Jinchen-Yang/race-car/README.md

# race-car — 2026 电赛自动行驶小车(TI MSPM0G3507)

北邮 2026 电赛小车赛道题固件:220×120cm 场地、双 R=40cm 半圆弧黑线 + 空白直线段,
要求自动巡迹一圈(F1 ≤30s)、定点瞄准(F2 ≤5s)、巡迹+对靶联动(F3 ≤40s)、四圈连跑(发挥)。

**当前状态**:循迹全线已通(单圈 ≈20s,真机验收)·r37 AIM 云台恢复 + Serial Studio CSV 灰度抗阴影/I2C 排障版。

---

## 1. 硬件

| 部件 | 型号/说明 | 接口 |
|---|---|---|
| 主控 | LP-MSPM0G3507 LaunchPad | — |
| 电机驱动 | 成品四路板(2×TB6612FNG),Motor A=左 B=右 | PWM: TIMA0 PA8/PB9;方向 PA12/PA13/PB6/PB7;STBY PB0 |
| 编码器 | MG310 自带 AB 相(左 QEI 4倍频 / 右 GPIO 1倍频) | 左 TIMG8 PA29/PA30;右 PA27/PB24。**r20 起仅作遥测,不参与控制** |
| 灰度 | 感为 8 路 IIC 版(Rev V3.6),地址 0x4C | I2C1 PB2/PB3 |
| IMU | MPU6050(GY-521),yaw 左转为正 | I2C0 PA0/PA1 |
| 云台 | 水平 360°连续舵机实际接 TILT/PA16; 垂直 180°位置舵机实际接 PAN/PA17 | 舵机轨开关 PB23(限制⑥) |
| 激光 | 装于 PAN 云台,与镜头位同轴向;供电走舵机轨 | — |
| 视觉(选配) | K230(CanMV),跑 `k230_aim_main.py` | UART2:PB17→K230 RXD,PB16←TXD |
| 人机 | START=PB19 MODE=PA22 蜂鸣=PB18 RUN灯=PA24 ERR灯=PA26 | 调试串口 UART0(XDS110) |

供电:电机/驱动板走电池 Vin;主控+灰度暂走 USB/充电宝(5V buck 割接待做);舵机轨接驱动板 5V。

## 2. 固件架构(r25 起,CTY 式)

```
scheduler(1ms 时基) ── 任务表轮询
├─ track_loop_step(20ms)  转向核: 一切误差统一折算成 DeltaYaw(°) → PD → 左右差速占空
│    ├─ 弧线段: 灰度 8 位查表(±5/15/25/40°) + 丢线强拐搜索
│    ├─ 空白段: 绝对航向保持(段0 目标=z, 段2 目标=z+180; z=START 时车头方向)
│    └─ 四段状态机: 压线/离线事件驱动(漏积分计数认线), 一圈 4 节点 B/C/D/A
├─ vel_loop_step(10ms)    r20 起仅编码器测速遥测(速度闭环已弃用)
├─ app_fsm_step(10ms)     IDLE/RUN/AIM/STOP/ESTOP; 节点声光/模式路由/四圈计圈
└─ task_vofa / task_cmd   24 通道遥测 + 串口命令台
```

模式(IDLE 下 MODE 键循环或串口发 1~4,RUN 灯每 2s 闪"模式号"次):
**1**=F1 巡迹一圈停 A · **2**=F2 定点瞄准 · **3**=F3 到 B 停车对靶后续跑 · **4**=四圈连跑(每圈过 A 限幅重锚 ±10° 清陀螺漂移)。
START 起跑;运动中任意键=急停;ESTOP 下 2s 内三连按 START 软清障。

## 3. 定版参数(真机整定,2026-07-06)

| 参数 | 值 | 含义 |
|---|---|---|
| TRACK_KP / TRACK_KD | **6.0 / 2.0** | SelfTurn PD(占空差/°);TRACK_KP 只用于直线航向保持 |
| TRACK_KP_ARC | **3.5** | r32 增益分家:弧线质心专用 KP(`P/p` 调的是它);曾用 6.0,弧上激出 S 型极限环 |
| BASE_SPEED | **170** | 巡航占空(r25 起是占空不是 mm/s)。⚠r39 起弧线曲率前馈 ∝ base,改基速会同步改变前馈量 |
| DRIVE_TRIM_DUTY_R | **5** | 右轮占空配平(`T/t` 调) |
| ARC_FF_EN / ARC_RADIUS_MM / WHEEL_TRACK_MM | **1 / 400.0 / 140.0** | r39 弧线曲率前馈:`ff = base·track/(2R)`。⚠轮距 140 为**估值**,实测后回填 |
| GRAY_LOOKAHEAD_MM | **110.0** | r40 传感器前置量:灰度阵列中心→驱动轮轴的纵向距离。决定出弧时前馈再托几帧。⚠**估值**,尺子量了回填。判据:CSV 里 `seg` 从 1 跳到 2 那一拍的 `dy` 应≈0(强负=欠转,强正=过转) |
| SEG_LINE_TH / SEG_BLANK_TH | 8 / 16 | 认线≈5帧 / 认空白≈16帧(勿轻动:调松到 63 曾致误触发链) |
| START_PROTECT_MS | 1500 | 起步 1.5s 无视灰度(摆车须离胶带 ≥50cm) |
| 每圈重锚限幅 | ±10° | 模式 4 专用;r39 起是纯陀螺漂移的**唯一**长期基准(模式 1/3 单圈内无任何修正) |

> r39 弧线整定判据(与基速无关):弧上稳态时 CSV 的 `gray_err` 应落回 0 附近(r38 及以前常驻 ≈+71,线骑阵列外缘)。仍偏正=`WHEEL_TRACK_MM` 估小了,偏负=估大了,按 `|gray_err|` 比例回填。

## 4. 构建/烧录/调试

- **环境**:CCS Theia + MSPM0 SDK 2.10.00.04 + SysConfig 1.26.2 + tiarmclang(工程内 .cproject 已配好,导入即编)
- **水印制度**:每次烧录后看 boot 串口横幅的 rN 版本号,与预期不符=烧了个寂寞
- **Serial Studio 临时灰度排障模式**:`empty.c` 里 `SERIAL_STUDIO_CSV=1` 时,串口每 50ms 输出纯数字 CSV: `ms,state,gray_err,lost,fresh,ok_delta,fail_delta,raw_or_neg1,gray_hits,line_ok,gray_min_hits,aim_stop_us,trim,arc_kp_x100,kd_x100,arc_scale_x1000,base,line_kp_x100,dy,seg,turn_diff,left_duty,right_duty,nodata,protect_ms,startprot_ms`。Serial Studio 选 XDS110 串口、115200、Quick Plot 即可;重点看 `fail_delta` 是否随晃线冒尖、`raw_or_neg1` 白地是否约 255；若 `fresh=0` 则 `raw_or_neg1=-1`,表示原始字节无效。`gray_hits` 是本帧黑点数,`line_ok=1` 才会被循迹当真线; `G/g` 调 `gray_min_hits` 抗阴影,`Y/y` 调水平连续舵机停转脉宽 `aim_stop_us`。CSV 模式下 `P/p D/d A/a V/v H/h T/t G/g Y/y O/o` 字符调参静默生效,参数列会跟着跳变;突然右转时看 `seg` 是否提前从 0 跳到 1、`turn_diff` 是否为负、左右占空是否拉开。
- **VOFA+**:`SERIAL_STUDIO_CSV=0` 时恢复 JustFloat 24 通道。要点通道:I0 状态机 · I10 灰度质心 · I11 丢线 · I15 灰度原始字节(白地=255) · I13/I14 灰度 I2C 成败计数 · I20 当前段目标航向 · I21 转向量 · I23 右轮配平
- **命令台**(VOFA 发送框):`1~4` 模式 · `s` 启动 · `x` 急停 · `r` STOP 回待机/ESTOP 三连确认 · `P/p` 弯道KP±0.5 · `D/d` KD±1 · `A/a` 灰度质心到角度比例±0.01 · `V/v` 基速占空±10 · ~~`H/h` 直线航向KP~~(**死旋钮**:`g_heading_kp` 属 r20 盲走架构,r25 段状态机上线后无人引用,调它只改回显不改行为;直线 KP 是定版 `TRACK_KP=6.0`,不在线调) · `T/t` 右轮配平±3 · `G/g` 灰度门槛±1 · `O/o` 舵机轨上/下电 · `C` 云台中位 · `J/j` PAN±1° · `K/k` TILT±5° · `Y/y` 连续舵机停转脉宽±5us · `?` 回显+帮助。
- ⚠ 串口在线调的参数**断电即失**,定版值必须写回 `app.c` 常量再烧

### 舵机/云台快调

当前安全初值在 `servo.c`:50Hz、0.6~2.4ms、PAN 10..170°、TILT 40..140°、中位 90°。r37 实测通道角色相反:水平 360° 连续舵机在 `SERVO_TILT/PA16`,垂直 180° 位置舵机在 `SERVO_PAN/PA17`。AIM 默认 `AIM_FIXED_MODE=1`: 前 305ms 给水平连续舵机手势脉宽,之后发 `aim_stop_us` 停转保持;垂直位置舵机斜坡到 `AIM_ELEV_DEG`。若水平舵机蠕转,在 IDLE/STOP 下先 `O` 上电,用 `Y/y` 微调到不转,再把回显值写回 `AIM_CONT_STOP_US`。

## 5. K230 视觉(选配,拔掉不影响 F1~F3)

`k230_aim_main.py` 跑在 K230(CanMV IDE 调阈值,部署=存板上 main.py):黑阈值找靶心 →
每帧发 `AA 55 06 05 dxL dxH dyL dyH found CHK 0D`(协议见 `protocol.h`,主控 `k230.c` 解析,
200ms 无帧自动回退纯几何瞄准)。接线:K230 4pin 口 TXD→PB16、RXD→PB17、共地;K230 开机需 ~10s。

## 6. 待办与已知问题

- [ ] 瞄准标定:场地常量已实测(AB=1000 / 靶投影 530 / 靶心高 500 / 舵机轴高 161.5 mm;解算角 +133° → **云台中位必须装成指左**),按 `servo_gimbal_bringup.md` 回填端点/零点/符号
- [ ] 已知偶发:高速垂直冲线偶尔认不出(≈3 帧 < 认线 5 帧);根治方案=触线降速确认,待实施
- [ ] 供电割接(5V buck 上车)、F1 录像、模式 4 四圈复测(r29)、F3 干跑
- 调试全史见 `git log`:每轮改动一条 commit,含现象→机理→修复的完整记录

## 7. 文件导览

`app.c/h` 控制核+状态机(主战场) · `empty.c` 调度/遥测/命令台 · `gray.c` 感为灰度 · `mpu6050.c` IMU ·
`motor.c` TB6612 · `encoder.c` 编码器 · `servo.c` 云台 · `k230.c` 视觉收帧 · `protocol.h` UART 契约 ·
`vofa.c` JustFloat · `pid.c` PID · `scheduler.c` 任务表 · `k230_aim_main.py` K230 端脚本 ·
`servo_gimbal_bringup.md` 舵机/云台现场调试步骤 ·
`固件交接说明.md` / `功能状态清单.md` 交接文档
