Jinchen-Yang/race-car/硬件参数与采样率审计.md

# 硬件参数与采样率审计（r31 基准）

> 2026-07-07 · 审计对象 = commit `8b7047d`（r31）· 方法 = 多代理并行：逐模块「代码配置提取 ↔ 产品数据手册检索」对照 + 架构/PID/编码器/症状四维分析。
> **可信度注记**：MG310 的数据手册检索因官方规格表难以获取被手动截停，其参数为社区级（community）来源 + 代码标定值自洽性交叉验证；对抗验证阶段被截停，控制层结论未经二次怀疑者复核，但全部结论带 file:line 证据可自查。舵机型号代码/文档均未记载，按 MG996R 类 180° 舵机取值（标注 estimate）。

---

## 0. 结论速览

**采样率层面：不存在"代码要求硬件做不到"的致命高估。** 全链路每个环节的消费率都低于上游生产率，方向整体安全。真正的错配是以下 4 处「隐性高估」——不是高估采样率，而是高估了硬件的**时间稳定性/数据新鲜度**：

| # | 错配 | 严重度 | 一句话机理 |
|---|---|---|---|
| 1 | **MPU6050 零偏：一次上电校准 ≠ 全程有效** | high | datasheet 温漂 ~0.1°/s/°C，冷启动自热 1~3min 漂 0.3~1°/s（18~60°/min）；40s 一圈可漂 12~40°，击穿模式 4 的 ±10°/圈重锚预算 |
| 2 | **K230 数据：30Hz 生产被 100Hz 积分消费** | medium | aim_refine 每 10ms 对**缓存帧** pan+=K·dx，无新帧标志，同帧重复积分 ~3.3 次 = 等效增益 ×3.3 + 50~100ms 管线延迟 → 瞄准过冲/振荡结构性风险 |
| 3 | **舵机端点 0.5–2.5ms 为占位值，超 datasheet 名义 1.0–2.0ms** | high | 未标定就全量程扫会顶机械限位堵转（5V 下 ~2A）；servo.c:32 注释自认待整定 |
| 4 | **TB6612 换向：占空可单拍正负翻转，无零占空间隙** | high | plug-brake 瞬时电流超可重复额定（连续 1.0~1.2A），泵升冲击 15V 绝对最大值（满电 3S 12.6V 余量仅 2.4V）。注意 3.2A 是单次 10ms 脉冲额定，不是承受力 |

**低估/闲置侧**（硬件能力白送没用的，按收益排序）：两路 I2C 停在 100kHz（芯片双方都支持 400k，IMU 帧时间可从 1.8ms 压到 0.5ms）；VOFA 阻塞发送吃掉每 20ms 里的 8.7ms（DMA/中断发送闲置，**单一最大延迟源**）；MPU6050 片内温度计每帧已读入却被丢弃（恰是治温漂的免费抓手）；灰度 8 路模拟量/归一化校准未用（1bit/路 vs 硬件 10bit ADC）；舵机命令量化 1°（硬件可分辨 0.45°，且 (int) 截断引入 ~1° 系统性负偏，直通打靶精度）。

**"第一次顺畅、之后跑不直"——电池假设被定量降级，top2 嫌疑是：**
① **IMU 零偏温漂 + 校准时机**（boot 唯一校准、0.3°/s 死区把静止自检遮蔽、自检失败不拦截 START）；
② **充电宝供电波动 × 一个真实代码缺陷**：灰度 I2C 失败时 `s_last_byte` 冻结（gray.c:93），track_loop 无条件消费陈旧字节（app.c:485）→ 段状态机冻结或误推进。烧录后首跑大概率还挂电脑 USB（供电最干净），之后换充电宝即恶化——与症状时序吻合。
电池压降本身：双轮同比例变慢，曲率几何近似不变，直线有陀螺闭环兜底——**解释"变慢"（-15~25%），解释不了"不能直线"**；且变慢让 SEG_LINE_TH=8 更容易认线，门限失配方向与"掉电变差"相反。电池的真实作用路径是**开环占空 + 固定 TRIM 的失配**（G∝Vbat，app.c:133 注释自认），属二阶贡献。

**左右编码器方案不对称（左 QEI 4x / 右 GPIO 1x）：不会"永远调不好"，且当前零影响**——r20 起编码器仅遥测，不进任何控制回路。详见 §3.3。

---

## 1. 全链路速率对照表

| 环节 | 硬件生产率（datasheet） | 代码消费率 | 判定 |
|---|---|---|---|
| MPU6050 寄存器更新 | SMPLRT_DIV=9 → 100Hz（DLPF 42Hz/4.8ms 群延迟） | task_imu 10ms 轮询（100Hz） | ⚠ 两个异步 100Hz 裸跑无 DATA_RDY 同步 → 拍频性重复帧/跳帧；真实 dt 积分可补跳帧、补不了重复帧。免费解法：DIV=0（内部 1kHz）或 INT 引脚同步 |
| 感为灰度内部刷新 | ≈1.5kHz（手册 §6.1），探头响应 1.5ms | 50Hz（20ms 拍读 1 字节 0xDD） | ✅ 30 倍余量，50Hz 与控制拍匹配属有意设计 |
| MG310 编码器脉冲 | 300mm/s 时左 ~2.1kHz(4x)/右 ~0.5kHz；占空 600 上限 ~1200mm/s 时右轮沿间隔 484µs | 左 QEI 硬解码 / 右 GPIO 中断（可锁存 1 个沿） | ✅ 丢脉冲无现实风险（I2C 忙等不屏蔽 NVIC）；真实病灶反而是毛刺**多计数**（无格雷码校验，实测 +14%） |
| K230 视觉帧 | find_blobs 管线 ~30fps（640×480，CPU-bound；sensor 本身 90fps 有余量） | FSM 10ms 拍消费缓存值 | ⚠ 见 §0-2，唯一实质性"高估"类错配 |
| 舵机脉宽采样 | 模拟舵机每 20ms 采一次脉宽（50Hz 帧） | AIM 态 100Hz 写 CCR | ⚠ 超帧率写入无收益，且异步直写跨比较点可偶发一帧异常脉宽（未配 shadow load） |
| 电机 PWM | TB6612 上限 100kHz | 20kHz（TIMA0 32MHz/1600，推断值，LOAD=1599 实测注释佐证） | ✅ 实用甜区；1600 级 > 软件 1000 级标度 |
| UART0 遥测 | 115200（实际 115207，+0.006%） | 100B/20ms ≈ 43% 带宽 | ⚠ 带宽够但**阻塞式发送**吃 CPU 8.7ms/20ms，见 §3.1 |
| 调度时基 | SysTick 32000@32MHz = 1.000ms | 1ms 任务表轮询 | ✅ 数值精确；隐患是全案 4+ 处隐式假设主频 32MHz 无 static_assert |

---

## 2. 分模块审计

### 2.1 主控 MSPM0G3507 —— 判定：代码低估硬件（保守但自洽）

- 主频跑默认 32MHz（上限 80MHz），当前负载够用；但 SysTick 周期、两个 PWM 分频、I2C 超时空转数、recover_delay **全部隐式绑定 32MHz**，提频时至少 4 处需同步手改，漏一处即静默漂移。
- 两个关键值不在 syscfg 显式锁定、纯靠 SysConfig 默认：**TIMG8 QEI 的 LOAD/回绕模数**（encoder.c:46 按 65536 写死，自注"待对账"，仓库无生成产物可查）与**两路 I2C 速率**（100kHz）。工具升级/重新生成无编译期防线。
- I2C0（IMU 专线，PA0/PA1 恰是 ODIO 脚，硬件可到 Fm+ 1Mbps）停在 100kHz：14 字节读 ~1.8ms 占 10ms 拍的 18%。提到 400kHz 是零硬件改动的 4 倍收益（GY-521 板载上拉需先确认撑得住）。
- ADC（12 位 4Msps）未用——灰度选了 I2C 数字版，合理；若 I2C 灵异问题再犯，模拟灰度+片上 ADC 是现成退路。

### 2.2 TB6612FNG —— 判定：混合

| 参数 | datasheet | 代码/实况 | 判定 |
|---|---|---|---|
| PWM 频率 | ≤100kHz，实用 10~20kHz | 20kHz | ✅ 甜区 |
| 斩波模式 | IN 定方向+PWM 斩波 = short-brake 慢衰减，低占空线性最好 | 正是该模式（motor.c:49-81） | ✅ 最优选择 |
| VM 电压 | 工作 4.5~13.5V，绝对最大 15V | 电池 ~12V 直供 | ✅ 仅限 3S 锂电（满电 12.6V）；**换 NiMH 10 节/铅酸"12V"（满电 13.8~14V）即超范围**，建议在文档注明"仅限 3S" |
| 电流 | 可重复 1.0~1.2A 连续/2A 短脉冲；3.2A 仅单次 10ms | 无限流、无换向斜坡 | ⚠ 换向 plug-brake 瞬态是真实应力点；把 3.2A 当承受力属误读 |
| STBY | 所有输入脚内置 200kΩ 下拉，悬空=待机=安全 | motor.h:11 称"内部无可靠下拉" | ✖ 注释对芯片事实陈述错误（外接 10k 属加固而非唯一保障），会误导维护者 |
| 逻辑电平 | VIH≥0.7×Vcc：板上 Vcc 若接 5V 则阈值 3.5V > 主控 3.3V | 接线未在代码/文档体现 | ❓ **需现场确认四路板逻辑 Vcc 接 3.3V 还是 5V**——接 5V 属 out-of-spec 碰运气 |

另：驱动层无待机闩锁——motor_set 每次调用无条件重抬 STBY，"急停后保持待机"完全寄生在上层 g_state 门卫纪律上（架构性埋雷）；TSD(175°C)/UVLO 自恢复失效在开环+无反馈下不可感知，表现为"跑一会儿丢力矩"，列为已知盲点。

### 2.3 MG310 电机 + 编码器 —— 判定：标定自洽（手册检索被截停，社区级数据）

- 社区来源：轮趣科技（WHEELTEC）MG310/MG370，12V，霍尔 13PPR 或 GMR 500 线两种版本，常见减速比 1:20/1:30。
- **代码标定值自洽性验证通过**：右轮 254.35 计数/圈（1x）÷ 13PPR ≈ 减速比 1:19.57 ≈ 标称 1:20 ✅；左轮 1017.4 = 4×254.35 精确成立（4 倍频比恒等）✅ → 本车是 13PPR 霍尔版、~1:20 减速比。
- **真值三处不同步（high）**：encoder.h:46 已定案 254.35（2026-07-05 推车实验），但 app.c:57 注释与 功能状态清单.md:23 仍写 **265.2——那是被接触抖动污染 +4% 的废值**（当年闭环因此把右轮灌快 4% → 白地持续左偏）。**请把清单里的 265.2 更新为 254.35**，防止下一个接手的人按废值重标。
- 量化分辨率：10ms 窗 @300mm/s，左 ~20.7 计数（±1 计数 = ±14.5mm/s，4.8%），右 ~5.2 计数（±58mm/s，**19.4%**）——右侧测速噪声天然大 4 倍，只遥测时无害。
- 电机额定 7.4V 对电池 12V：靠 MOTOR_MAX_DUTY=600（60%）防超压，此约束勿动。

### 2.4 感为 8 路灰度（I2C 版 V3.6）—— 判定：代码低估硬件

- 内部刷新 ≈1.5kHz、探头响应 1.5ms vs 代码 50Hz 读——30 倍余量，良性。协议/极性/上电 ping 全部匹配手册，总线独占纪律（IMU 按地址路由走 I2C0）是对"从机会被跨地址流量搞死"怪癖的正确工程响应。
- **⚠ I2C 上拉电压疑似不满足手册硬性要求（medium）**：手册要求上拉电压 ≥3.6V（72%×5V），低于阈值"通讯极易失败"。主控总线是 3.3V（低于阈值）；若启用传感器板载 10k@5V 上拉，PB2/PB3 又**不是** 5.5V 耐压 ODIO 脚（只有 PA0/PA1 是）——两头都不干净。7-04 排障史里灰度"值日式"掉线可能与此有关，建议实测总线高电平。
- **⚠ 陈旧字节缺陷（medium，与症状直接相关）**：I2C 读失败时 `s_last_byte` 冻结（gray.c:88-93 失败早退不更新），track_loop 无新鲜度判断直接消费（app.c:483-486）——连续失败期间段状态机吃冻结字节：旧字节含线 → 永远"在线"、朝固定方向拐死；旧字节 0xFF → 提前认空白、段误切、目标航向翻转 z+180 = 突然掉头。故障仅在 ch14 可见，控制层零降级。硬件其实给了 0xDE 错误查询/0xC0 软重启命令可作运行时自愈，未用。
- **前瞻雷区**：待做的 5V buck 割接若把灰度与舵机并同一 5V 轨，直接违反手册"严禁与舵机/电机等感性负载共 5V（尖峰烧毁传感器）"强制条款——割接方案给灰度独立 LDO 或磁珠隔离。
- 模拟量通道（10bit ADC×8 路 + 0xCF 归一化）整体闲置：CTY 方案有意取舍非缺陷；但若要提基速/减小蛇形，连续质心是硬件已付费、代码未取用的升级路径。

### 2.5 MPU6050 —— 判定：混合（本车最大的硬件-代码错配所在）

配置本身全对：CLKSEL=1（PLL X 陀螺，官方推荐）、±250dps 最小量程榨分辨率、DLPF 42Hz 压车振、每次上电必校准、真实 dt 积分（优于常见固定 dt 写法）。错配全在**时间维度**：

1. **（high）上电即校准、无热机、无温补、START 前不重校**：ZRO 温漂全温区 ±20°/s、实测 ~0.1°/s/°C；冷启动 1~3min 自热数 °C → 校准时刻的偏置随温度移走 0.3~1°/s = 18~60°/min。40s 一圈可漂 12~40°，击穿 ±10°/圈重锚预算。
2. **（medium）0.3°/s 死区把自检变成半盲**：残余偏置 <0.3°/s 时静止积分恒零、自检必过；车一动（|gz|>死区）偏置**全额**混入积分——0.3°/s = 18°/min ≈ 12°/40s 圈。自检证明的是"静止时不漂"，不是"运动积分时偏置为零"。
3. **（medium）校准/自检 3 轮全失败仅打印+亮灯，仍放行 START**：未去偏置的纯积分 yaw 最坏 1200°/min，状态机却允许带垃圾 yaw 起跑。
4. **（low）片内温度计（340 LSB/°C）每帧已读入 out->temp 后被丢弃**——对付头号误差源（温漂）的免费传感器在手边。做一条 `bias(T)=bias0+k·(T−T0)` 逐板线性补偿可把升温期漂移压一个量级，数据已在手、成本为零。
5. （low）校准 600 帧背靠背读快于 100Hz 寄存器刷新：500 个平均样本实际只含 ~110 个独立样本，方差虚标一倍（恒温下本身很小，不致命）。
6. 注释勘误：mpu6050.c:61 "DLPF ~44Hz(陀螺)"——42Hz 才是陀螺，44Hz 是加计的。

### 2.6 PAN 舵机（MG996R 类，型号未记载）—— 判定：混合

- **（high）脉宽端点 0.5–2.5ms 与限位 0–180° 均为占位**，超 datasheet 名义 1.0–2.0ms/120°；实物未标定就全量程扫（AIM 几何解算角接近端点时）= 顶机械限位持续堵转（5V 下 ~2A，烧齿轮/拉垮电源轨）。**装机后必须先扫两端实测回填再跑 AIM**（servo.c:32-37 注释自认待整定）。
- **（high）"轨可控"假设未落地**：软件全套按 servo_rail_enable(PB23) 设计（AIM 进出开关/急停断轨/默认断电），实物红线直连驱动板 5V = 空操作——题目限制⑥"默认不通电"实际不满足，上电即扫 90°。MOS 开关须按 ≥2.5A 瞬态选型；驱动板 5V 稳压器若是 AMS1117 类 LDO（≤1A），单只舵机瞬态即可拉垮共轨的 TB6612 逻辑供电。
- （medium）精度断层：硬件死区 5µs≈0.45°、定时器 0.045°/LSB，但 `servo_set_angle(int deg)` 量化到 1° 且 app.c:660 用 (int) 向零截断——丢一半可用分辨率 + 最大 ~1° 系统性负偏（靶距 L 处 ≈ L×17.5mm/m）。K230 精修链路全程 float，最后一步被 API 签名卡死。
- （medium）无斜坡限速：进 AIM 从 90° 一步跳目标角，满速扫动瞬态电流接近堵转量级；建议 ≤3°/10ms 斜坡。
- （medium）100Hz 写 CCR > 50Hz 舵机帧，且未配 shadow load，跨比较点写可偶发一帧错误脉宽——降 50Hz 同步写。

### 2.7 K230 CanMV —— 判定：混合

- 链路本身健康：波特率两端一致（带宽余量 30 倍）、RX 中断+128B 环形缓冲+5ms 消费（2.2 倍余量）、200ms 失联回退纯几何（≈6 帧容错）、未收帧哨兵设计正确、开机 10s 已兜底。
- **（medium）唯一实质性错配**：aim_refine_k230 以 100Hz 积分式消费（pan+=K·dx）30Hz 生产、50~100ms 延迟的**缓存帧**，无新帧标志——同帧重复积分 ~3.3 次 = 等效增益 ×3.3，叠加管线延迟（舵机已动、相机还在报旧偏差）= 过冲/振荡结构性风险。修法：k230.c 加 fresh 标志，仅新帧到达才积分（或增益 ÷3.3 起步整定）。
- （medium）板卡实证缺口：帧率结论建立在"OV5647 @640×480"上，01Studio 版板载 GC2093 无该原生模式，脚本注释又引亚博文档——**上电看一次启动日志/加 clock.fps() 打印即可闭环**。
- 流程注意：K230 须比进 AIM 态早 ≥10s 上电，否则 5s 瞄准窗内只有纯几何指向，AIM_TIMEOUT 会静默超时离场。

---

## 3. 控制层分析

### 3.1 架构（总体合理，一处结构性主矛盾）

1ms SysTick 置标志 + 主循环 run-to-completion 是本级别的标准形态；3 个 ISR 全最小化、共享变量在 M0+ 上原子、FSM 事件同线程无竞态、测速/陀螺已用真实 dt——这些都对。主矛盾：

- **（high）task_vofa 阻塞发送 100B@115200 ≈ 8.7ms，占 20ms 预算 44%**（empty.c:64-69 逐字节忙等）。健康路径 I2C 再吃 ~4ms，基线负载已 ~63%；叠加 I2C 失败毛刺（~3.4ms/次，总线丢包率 10~20%）或 '?' 状态打印（~7.8ms），单次循环可击穿 20ms → track 就绪标志被合并，实际周期跳 40ms。**修法：TX 环形缓冲+UART 发送中断（与 k230 RX 镜像对称），或降频 50~100ms/砍通道。**
- **（medium）dt 体系不一致**：测速/陀螺积分用真实 dt，但转向 PD 的 D 项与全部保护窗/超时（起步 1500ms/切换 1000ms）仍按名义 20ms 递减——I2C 拖延时 D 项等效增益漂 ±30%+、保护窗被拉长，与 r31 刚修的"假事件链式推进"同一敏感区。修法：D 项乘 (20/dt_real)，计时改 g_tick_ms 时间戳差（k230_age_ms 已是正确范本）。
- （low）sched_run 的 check-then-clear 与 SysTick 竞态：仅在任务已被拖延整周期时才可能吞一拍，run 改计数器可根治；app_estop 注释宣称"可在中断里调"实际不安全（当前所有调用方都在主循环，潜伏未触发）——删注释或改标志位模式。

### 3.2 PID × PWM

现役转向核**没有积分项**，windup 之忧不存在于活代码；问题集中在 D 项与执行器衔接：

1. **（high）直线段纯 PD 无积分、无横向反馈 → 恒定航向残差是"跑不直"的解析解**：持续不对称力矩 Δ 需要恒定差速维持直行，纯 P 只能靠恒定误差供给 dy_ss=Δ/KP（Δ=12 占空、KP=6 → 2°），1.4m 直线侧偏 ≈49mm，方向随哪侧电机弱/电量高低翻转 = "时左时右"。手动 TRIM 是开环前馈，电压一跌即过时。修法：直线段加条件积分小 Ki（|diff| 未饱和才积，限幅 ±30 占空，进段清零），或 TRIM 按电池电压查表。
2. （medium）D 项对 gray_ladder 的 10° 量化台阶直接差分、无低通：骑缝时 dy 在 ±5° 间翻转 → D 单拍 20 占空、最高 25Hz 方波 = 车身高频蛇形。修法：dy 一阶低通（α≈0.3~0.5）或查表迟滞。
3. （medium）段切换/AIM 返回不清 g_dyaw_prev：误差源硬切（航向↔±40° 查表↔±50° 强拐）产生一拍 derivative kick 顶满限幅，加剧"进弧甩头"。一行修复：g_seg 变更时 g_dyaw_prev = dy。
4. （medium）死区无补偿 + dl=base−diff 可穿零：base 在线调到 60 而 diff 上限 150 时 dl=−90 直接反转左轮，转向特性突变；MG310 静摩擦死区内命令与轮速脱钩（粘滑）。**好消息：限幅顺序正确**——先夹 diff 再叠加 base，最大 |dr|=490 < 600 硬限幅，当前参数下不存在"饱和吃差速"。
5. 闭环路径两颗沉睡雷（切回 DRIVE_OPEN_LOOP=0 前必修）：增量式累加器限幅 ±1000 vs 执行器 600 → 400 占空隐藏 windup 区（pid.h "天然抗饱和"注释失实）；位置式 pid_update 饱和期照常积分（仅 clamp，无条件积分），且 integ_max=0 语义是"积分恒零"而非"不限幅"，API 陷阱。
6. 状态清零链健康：IDLE→RUN 对全部控制状态逐项复位（app.c:723-762），无跨 RUN 残留。

### 3.3 左右编码器方案不对称——直接回答

**结论：不会"永远调不好"，且在 r20 之后的当前架构下此问题不影响行驶（编码器仅遥测）。**

- 4x/1x 是**标度差**：代码已按轮分别换算（1017.4/254.35 计数/圈），一个常数标定掉，历史也证明了——当年"白地持续左偏"的元凶是右轮标定被毛刺污染 +4%（265.2），r11 换理论值 254.35 即修复。标度类误差完全可标定。
- 真正不可标定的是**量化分辨率差 4 倍**：右轮 10ms 窗 ±1 计数 = ±58mm/s（@300mm/s 是 19.4% 噪声/样本），左轮仅 ±14.5mm/s。若恢复闭环，右环必须更重低通+更低增益，左右动态带宽注定不对称——**"能调到共速，但右环更肉、抖动更大"**，不是调不好。
- 右轮 1x 能判方向（A 上升沿采 B 电平）；丢脉冲无现实风险（占空 600 上限时沿间隔 484µs，I2C 忙等不屏蔽 NVIC）；**真实病灶是毛刺多计数**（无 QEI 格雷码校验，动力线耦合，实测单次 +14%）。
- r20 弃闭环的直接原因是**两个编码器硬件带病**（左轮间歇无信号、右轮 ±20% 毛刺，app.c:126-131 台架实锤），不是方案不对称。
- **若要复活闭环，先决条件按序**：①编码器线与动力线分开走线 ②右轮 ISR 加毛刺滤波（两沿间隔 <100µs 丢弃）③右轮 LPF 单独调小（~0.2）或改双沿 2x ④修 ±1000/600 限幅不一致 ⑤复核 QEI 模数 65536 对账。

### 3.4 症状诊断："烧录后第一次顺畅，之后不能直线/巡线"

按可能性排序（判别实验全部用现有 VOFA 24 通道，零成本）：

| 排序 | 假设 | 判定 | 判别实验 |
|---|---|---|---|
| **1** | **IMU 零偏温漂/校准时机**：boot 唯一校准；首跑（烧录后）车静置久=校准最好；后续快速重启+搬车=校准吃运动样本；跑几趟后升温=零偏移走；0.3°/s 死区让静止自检看不见 ≤18°/min 的运动期漂移 | high | 跑一趟坏的：**ch4(DeltaYaw)+ch21(差速) 对照目视**——车在画弧而 ch4≈0/ch21≈0 = 控制器自认走得直 = yaw 参考漂了，IMU 实锤；每趟结束摆回出发朝向读 ch12 与 START 时刻差 = 整趟净漂移，趟间递增 = 温漂实锤 |
| **2** | **充电宝供电 × 陈旧字节缺陷**：首跑挂电脑 USB（最干净），后续充电宝低负载波动 → 灰度 I2C NACK 率陡增 → track_loop 吃冻结字节 → 拐死/段误切/掉头 | high | **ch14(灰度 fail) 斜率**：坏趟台阶/斜坡上涨 + ch15(原始字节) 长时间冻结 = 实锤；对照实验：同占空充电宝 vs 电脑 USB 各跑一趟比 ch14 |
| 3 | 模式 4 专属：过 A 重锚仍注入 ≤10°/圈出线姿态噪声（r29 是限幅不是消除），lap2 起步斜 | medium | ch20(段目标) 每次过 A 的台阶高度 ≈±10° 且方向与跑偏一致 = 实锤；修法：重锚改用"出线后直线段稳定 0.5s 的 yaw 均值" |
| 4 | 灰度环境劣化（白布被碾出新褶皱/光照渐变/传感器发热） | medium | 坏趟复盘 ch6(段号) vs ch15：空白直线位置 ch6 提前跳变 + ch15 杂散位 = 布面假黑 |
| 5 | 电池压降（用户首怀疑） | **low，大部分否决** | 满电 vs 亏电同占空各跑一趟，比 ch1/ch2 编码器计数斜率折算速度——降幅 <20% 而直线照崩 = 电池主因闭案否决。残余贡献走"TRIM 失配"路径（见 §3.2-1） |
| 6 | 跨 RUN 状态残留 | low，否决 | 第二次 START 后 ch6=0、ch4≈0、ch20=当拍 ch12 三者吻合即闭案（复位链已核对完备） |
| 7 | 机械打滑/舵机轨拉 5V | low，基本否决 | 陀螺闭环对打滑免疫；F1/F4 全程舵机轨断电、且与主控不同轨 |

---

## 4. 行动清单（按投入产出排序）

**先做判别（不改码，一个下午）**
1. §3.4 实验 1、2、6 各跑一趟——三个 VOFA 观察就能把 top2 假设定案。

**代码修复（小、独立、与判别结论无关都值得做）**
2. 灰度失败帧显式当"无数据"：gray_get_diag 加 fresh 标志，失败帧不推进 g_nodata/不喂 ladder（§2.4，直接堵症状假设 2 的代码放大器）。
3. START 前重校准：IDLE 静置检测 ≥2s 自动重校零偏 + 校准失败禁止 START（§2.5-1/3，堵假设 1）。
4. g_dyaw_prev 段切换/AIM 返回清零（一行，§3.2-3）。
5. VOFA 发送改 TX 中断/环形缓冲，或降 50~100ms（§3.1，还 20ms 拍 44% 预算）。
6. 文档同步：功能状态清单 265.2→254.35；motor.h STBY 注释更正；mpu6050.c DLPF 注释 44→42Hz。

**电气核验（万用表级）**
7. 四路板逻辑 Vcc 接 3.3V 还是 5V（§2.2）；灰度 I2C 总线高电平实测（§2.4）；确认电池为 3S 锂电（§2.2）。

**中期（割接/瞄准阶段做）**
8. IMU 温漂线性补偿（temp 数据已在手，§2.5-4）；I2C0 提 400kHz；K230 fresh 标志 + 增益重整定（§2.7）；舵机端点标定 + 1°→0.1° API + 斜坡限速 + 轨开关落地（§2.6）；5V buck 割接时灰度与舵机严禁共轨（§2.4）。
