Jinchen-Yang/race-car/功能状态清单.md

# 功能状态清单（2026-07-08）

> 四个状态等级：✅ 已达成(真机验证) / 🔨 代码已覆盖(未经真机验证或部分验证) / 🕳 占位(结构在、内容待填) / ❌ 未实现
> 对照对象：题目评分表（总 120 分）。

## 一、按题目评分项对照

| 评分项(分值) | 状态 | 明细 |
|---|---|---|
| **F1 自动巡迹+停车声光 ≤30s (20)** | **🔨 七成** | 连续线循迹 ✅(KP=0.4/KD=1.0 收敛)；停车+声光链路 ✅(已被误触发验证过)；断线段盲走 🔨(航向锁已实装但真机发散暂禁用, 现为"斜走凑合", 待 IMU 漂移体检定案)；整圈判定门限 🕳(330°+4m 理论值, 未实地校准)；30s 时限未实测(理论 ≈18s, 裕量足) |
| **F2 定点瞄准 ≤5s (20)** | **🔨 云台调试中** | 模式2 FSM 流程 🔨(START→AIM→5s 超时→STOP 走得通)；r36 已启用位置舵机几何解算(AIM_FIXED_MODE=0),舵机端点/零点/方向待现场扫角回填；K230 精修可选 |
| **F3 巡迹到靶联动 ≤40s (20)** | **🔨 五成** | 模式3 流程 🔨(B 停车对靶→C/D 过点声光→回 A 停, 代码全通)；B/C/D 门限 🕳(理论占位)；对靶作业依赖 F2(缺硬件) |
| **F4 工程训练项** | **🔨 八成** | 按键选模式 ✅(MODE 循环+灯闪反馈, 真机验证)；串口设模式/参数 ✅；r36 新增舵机轨/云台手动调试命令；模块独立供电仍需割接验证 |
| 发挥1 动态瞄准 (15) | ❌ | 依赖云台+K230, 硬件未到位 |
| 发挥2 同步绘制 (15) | ❌ | 依赖激光/画笔机构, 未购 |
| 发挥3 四圈连跑 (10) | ❌ | FSM 现为单圈停; 实现只需小改(圈计数)+可靠性验证 |
| 发挥4 工程完善度 (10) | **✅ 强项** | 急停逻辑(运动中任意键+锁存)、故障自愈(I2C 双总线恢复/火化/瞎油门保险丝)、开机自检(探针+校准+漂移)、19 通道遥测、git 版本管理、交接文档体系 |
| 设计报告+AI说明 (10) | 🔨 | AI 使用说明附录草稿 ✅(design/AI使用说明-附录草稿.md); 报告正文未写 |

## 二、按代码模块对照

**✅ 已实装且真机验证：**
motor(限幅+STBY 自动使能) / encoder(双路+实测标定 1017.4/254.35; 旧值 265.2 系接触抖动污染 +4% 已废弃, 见 encoder.h:39-46) / 速度内环(实测增益设计, 300mm/s 收敛, 稳态占空≈150) / gray(感为协议+±350 质心+方向定版=1号探头朝左) / 循迹外环(KP0.4/KD1.0) / IMU 链路(双总线+7+7读+5重试+容错校准, 运行丢包<0.1%) / bsp_i2c 五重防线 / 三模式任务框架+按键+急停 / 声光 / VOFA 19通道 / scheduler+真实dt体系

**🔨 已实装未(充分)验证：**
盲走航向锁(发散暂禁, 悬案=IMU漂移?) / KP_GATES B/C/D 分点序列 / F2/F3 FSM 流程壳 / k230.c 收帧协议(设备未接) / servo.c(r36 安全参数已下发, 待真机扫角) / 瞎油门保险丝(未真机触发过) / IMU 开机漂移自检+自动重校

**🕳 占位待填(结构在, 等实测/硬件)：**
AIM 舵机端点/零点/符号 / AIM 的 K230 精修增益与命中容差 / 轮径精标(现 50mm 粗测) / KP_GATES 门限实地回填 / 带载速度环增益复整 / LOST_BLIND_MAX 实地定值

**❌ 未实现：**
绘制与动态瞄准(发挥1/2)

## 三、硬件缺口清单

| 项 | 状态 |
|---|---|
| 5V buck(主控+灰度脱离 USB) | 已到货, **待割接** |
| 6V/≥3A buck(舵机轨) | 待购 |
| 舵机/二维云台 | 开始现场调试,端点/零点待回填 |
| 激光模块 | 待购(F2 视频证据的关键) |
| K230(庐山派) | 有货, 未接入(初赛非必需) |
| IMU 漂移悬案 | 待 tune-r8 固件的 boot 自检数据定案 |

## 四、到"过初赛(F1+F3 视频可交)"的最短路径

1. IMU 漂移定案 → 盲走航向锁复活(断线段直穿) 
2. 供电割接(脱 USB) → 车可自由跑
3. 真尺寸场地(220×120, R40)贴道 → KP_GATES 四点门限回填 → F1 全流程连跑+录像
4. 云台+激光到货装机 → aim_geometry 填真公式 → F2 → F3 全流程
5. 串口设模式(半天代码) → F4 补全
