Jinchen-Yang/race-car/scheduler.h

/* 裸机时间片调度（复用 KB08 模板，可主机编译/单测）—— firmware-scaffold 中间件层
 * sched_tick 放 1ms 定时器中断里递减计时；sched_run 放 main while(1) 跑就绪任务。
 * 任务表（周期）在 app 层定义，见 app_mission.c 的 g_tasks[]。 */
#ifndef SCHEDULER_H
#define SCHEDULER_H
#include <stdint.h>

typedef struct {
    void    (*task)(void);
    uint16_t period_ms;
    /* timer/run 跨"SysTick 中断(写) / 主循环(读清)"共享, 必须 volatile:
     * 否则编译器高优化下可能把 run 缓存进寄存器, 主循环看不到中断置的 1, 任务漏跑。 */
    volatile uint16_t timer;
    volatile uint8_t  run;
} task_t;

void sched_tick(task_t *tasks, uint8_t n);   /* 放 1ms 定时器中断：到点置 run */
void sched_run (task_t *tasks, uint8_t n);   /* 放 main while(1)：跑就绪任务 */

#endif /* SCHEDULER_H */
