Jinchen-Yang/race-car/(commit log)

2026-07-05 基线快照: 速度环闭环+双传感器交付+任务框架实装
    - 速度内环: 实测对象增益设计(Kp=0.15/Ki=0.03), 稳态占空150@300mm/s 验证通过
    - 灰度(感为ganv003): I2C1独占, 协议核定, 扫线±350满量程, 装车规则=1号探头朝左
    - IMU(MPU6050): I2C0专线(PA0/PA1), 7+7短读+5重试+容错校准+真实dt+0.3dps死区
    - bsp_i2c 最终形态: 按地址双总线路由/wait_started/i2c_fail火化半截事务/双总线9时钟开机恢复
    - 任务框架: F1/F2/F3三模式+MODE键切换(灯闪模式号)+运动中任意键急停+B/C/D/A关键点门限表
    - VOFA 19通道诊断体系(状态/编码器/速度环/占空/灰度/航向/双总线丢包计数/模式)
    -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
2026-07-05 docs: 交接说明状态速览刷新至 2026-07-05(验收后状态+VOFA 19通道表+排障方法论)
2026-07-05 safety: 速度环加'瞎油门保险丝'——占空饱和且测速为零500ms即急停(左编码器摔坏致全速失控的教训)
2026-07-05 tune: TRACK_KP 1.0->0.5 (首跑蛇形+弯道甩丢线, 外环第一轮整定)
2026-07-05 tune r3: TRACK_KP 0.5->0.3 + boot版本水印(防烧录未生效乌龙)
2026-07-05 tune r4: KP=0.4 + 首次引入 KD=1.0 (0.3弯道拉不住/回抬KP用KD压摆动)
2026-07-05 tune r5: 盲走航向锁启用(HEADING_KP=3.0)+锁'压线期滑动平均航向'而非瞬时值(修断线段走斜线)
2026-07-05 tune r6: HEADING_KP 符号翻转为 -3.0 (实测+3.0盲走打转=正反馈, IMU安装朝向定音)
2026-07-05 tune r7: 航向锁暂禁用——正负符号都打转=航向反馈本身异常(疑IMU校准未过yaw漂移), 待体检后再启用
2026-07-05 feat: IMU 开机自检自愈——校准后自动测2s漂移, >1°/2s 自动重校(最多3轮), boot 打印漂移率
2026-07-05 docs: 功能状态清单(评分项对照/代码覆盖四级分类/硬件缺口/过初赛最短路径)
2026-07-05 feat r9: 串口命令台(设模式/启停/在线调参KP·KD·基速)+四圈连跑模式4+急停三连按软清障
    F4串口设模式补全+发挥3代码部分+现场整定免重编译烧录。
    命令: 1-4模式 s启动 x急停 P/p D/d V/v 调参 ?状态
2026-07-05 feat r10: aim-geometry 落地真公式(atan2 解 pan/tilt, 停 B→靶几何) + 场地/云台/舵机常量组待整定
2026-07-05 feat: K230 端 main.py 骨架(黑阈值blob找靶心->AIM帧0x05, 与 protocol.h 逐字节对齐; 阈值/滤波参数待IDE实拍整定)
2026-07-05 fix r10: 注释里 CAR_GIMBAL_*/ 的 */ 提前闭合块注释导致编译错(app.c:400); 顺修 k230.h 注释 /* 警告
    [app.c, k230.h]
2026-07-05 tune r11: 右轮每圈计数 265.2->254.35(=左/4 理论值; 手转旧值被抖动+4%污染=白地左偏元凶, 推车对照实验定案) + 轮径 50->47 实测
2026-07-05 feat r12: 盲走航向锁 KP 转运行时变量+串口 'H'/'h' 在线调(±0.5, 唯一可负项); 白地残余左偏(<1%, 低于推车标定分辨率)改由 yaw 闭环吸收; 附符号判据与增益量级推导
2026-07-05 feat r13: VOFA 加 ch19=盲走航向锁KP —— 调参状态上波形通道, 不再在二进制乱码里捞'?'文本回显
2026-07-05 tune r14: 航向锁开机默认 0->+2.0 (脱机盲穿实验: 主控吃USB电+HKP断电清零, 在线调参带不出门, 故写死默认值)
2026-07-05 fix r15: AIM 入态开舵机电源轨/离开关轨 —— 全工程此前无人调 servo_rail_enable(1), MOS 开关装上后 F2/F3 会对着断电舵机瞄准(真机接云台时发现)
    [app.c, empty.c]
2026-07-05 fix r16: 盲走锁定值加快/慢双平均滞后外推 —— 弧线末端出线时滑动平均滞后 ω·τ≈17° 恒偏弯内侧, 真场地 6/6 全偏左实锤; 外推恒速转弯精确消滞后, 直线出线自动退化为纯平均, ±25° 保险夹
    [app.c, empty.c]
2026-07-05 fix r17: 盲走三重加固 —— ①START 清 g_blind_active(滞留旧锁定=启动即猛转的真凶, 真机转圈实锤) ②压线<0.6s 不加外推(平均未收敛) ③盲走转向量硬限幅±100(坏锁定最多缓弧, 物理上不可能转圈)
    [app.c, empty.c]
2026-07-05 feat r18: 弧末'边缘掉线补转' —— 紧弧P外环稳态偏差使线骑传感器边缘, 几何末端前就掉线, 剩余~30°弧没转完(用户观测'末端本应0°仍按30°走'); 判据=掉线时还在转弯且末帧|err|>边缘门限, 按原转向补转30°, 干净末端不补, 方向自适应
2026-07-05 fix r19: 对抗审计定案四合一 —— ①盲走解锁去抖3帧(弧末闪断循环把首锁好值秒换冻结fast裸值+online永到不了600ms='30°之谜'真凶) ②短压线再丢线沿用旧锁(拆'失败横穿→污染重锁→更斜入射'的转圈闭环) ③弧上曲率前馈(P环稳态偏差131=线骑边缘的总根源, FF接管后线回中央可跟到几何末端) ④回退r18补转(单帧判据零区分度+固定30°过补=右转圈直接推手); 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
    [app.c, app.h, empty.c]
2026-07-05 feat r20: 架构切换=编码器出局 —— 开环占空+陀螺/灰度差速直驱(DRIVE_OPEN_LOOP, 台架实锤双编码器带病后弃用轮速环, 借鉴2024H开源方案); 事件节点(压线400ms/正式出线)取代KP_GATES里程门限, 一圈4节点B/C/D/A免标定; 捕线强转非阻塞版(斜插|err|>250先原地对正再交PID); 编码器降级为纯遥测, 保险丝随速度环停用; 原mm/s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
2026-07-05 fix r20: 条件编译范围划错 —— KP_GATES(常量区)与 keypoint_event(函数区)之间夹着整个变量声明区, 一对 #if/#endif 把静态变量全吞了; 拆成两段各自包裹
    [app.c]
2026-07-05 feat r21: A=盲走航向PI(纯P顶不平左右电机不对称->恒定残差=直线时左时右元凶; 积分学掉不对称, 限幅30+每段清零) B=出线原地对正(锁定与车头差>6°先原地转到<3°再起步, 消灭边走边拉的横向积累; 沿用旧锁分支同样受益; 超时800ms保险; ch21=±999为对正段标记)
2026-07-06 revert r22: 停用盲走航向积分(HEADING_KI=0, 直线退回r20纯P行为) —— 用户观察到两轮转速明显不一致后叫停; 出线原地对正(r21B)保留; 备注台架伪象待厘清与'T/t'配平旋钮替代案
    [app.c, empty.c]
2026-07-06 r23: 出线对正加总开关并默认关(EXIT_ALIGN_EN=0) —— 应用户要求盲走完全回到 r20 行为做偏移对照; KI 已在 r22 关; 直线偏移的物理根源=开环下电机个体差异无人补偿, 三药: 速度环(编码器弃)/航向积分(用户叫停)/手动配平(待批)
2026-07-06 feat r24: 右轮占空配平旋钮(用户批准) —— 'T'/'t' ±3 夹±40, 出口级恒定偏置补电机个体差异; '?' 回显 TRIM + VOFA ch23; 调好后回填 DRIVE_TRIM_DUTY_R 默认值(RAM值断电即失); 出线对正按用户排程仍关(直线调好后再开)
2026-07-06 feat r25: 按用户指示移植 CTY(24H第四问开源)架构重写驱动核心 —— 统一 DeltaYaw 接口(空白段=场地锚定绝对航向 z/z+180, 弧段=灰度查表±5/15/25/40°, 弧内丢线保护窗强拐±50); 段状态机(漏积分计数快认线慢认空+切换保护窗+起步保护1.5s); SelfTurn PD 出差速开环占空; 旧锁定/外推/去抖/强转/对正体系整体退役; 基速语义改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
2026-07-06 tune r26: SelfTurn KP 3.0->7.5(用户真机整定, 循迹全线成功!) —— 稳态残差角机理验证: 残差∝1/KP, 拉高后起步/出弧右偏消失至可接受
2026-07-06 feat r27: 模式4 每圈过A重锚基准角 —— 陀螺漂移≈7°/圈四圈累20°+, 出弧车头≈A→B切线=场地真值, 逐圈清账(±30°门限防脏出线); 仅模式4路径, 已验证的模式1/3零改动
2026-07-06 tune r28: SelfTurn KP 7.5->6.0(用户复整定定版: 7.5偏激, 6.0手感最稳) + 水印同步
2026-07-06 fix r29: 模式4重锚限幅 ±10°/圈 —— r27整锚替换把出线姿态噪声(±15°)一次性注入下一圈=lap2起步右偏实锤; 改'旧z+夹幅修正', 漂移(7°/圈)吃得下, 噪声逐圈收敛不跳变
    [app.c, empty.c]
2026-07-06 fix r30: ①认线门限 8→63(3帧即认: 300mm/s垂直冲1.8cm线只有~3帧, 旧值5帧注定'碰线直走') ②起步保护 1.5s→0.8s(允许近距离起步测试, 摆车仍须离线≥30cm)
    [app.c, empty.c]
2026-07-07 revert r31: 认线门限63→8+起步保护0.8s→1.5s(整体恢复r28已验证组合) —— r30的63实为2帧即认(当时算错说3帧), 白布褶皱2帧误触发段状态机链式推进(目标航向翻转)='走走停停/F1崩'元凶; KP=6.0与模式4重锚保留
    [app.c, empty.c]
2026-07-07 docs: README 按当前工程重写(硬件表/CTY架构图/定版参数/调试台用法/K230协议/待办) + 删除 TI 样板 README.html
2026-07-07 fix r32: 防蛇形(只改移植引入+自家部分, 开源查表原样): ①增益分家 KP_ARC=3.5 弧线专用/'P/p'改调它, 直线KP定版6.0(移植耦合是S型元凶: 6倍增益放大查表台阶成极限环) ②段切换清D历史(防换源单拍甩头) ③灰度I2C失败帧判无数据不喂状态机(堵冻结字节拐死/段误切, 审计定案) ④VOFA 20→50ms(阻塞发送曾吃44%CPU)
    [app.c, empty.c, gray.c, gray.h]
2026-07-07 docs+tools: 硬件参数审计 + 现场调试指挥手册 + 遥测采集工具链(给现场端 Claude 的交接包)
    现象: 烧录 r31 后首跑顺畅, 后续不能直线/巡线; 初判"电池没电"。
    机理(多代理审计定量结论, 详见 硬件参数与采样率审计.md):
    电池假设降级为 low(开环下双轮同比例缩、曲率不变、直线有陀螺兜底,
    解释"变慢"解释不了"不弯直"); top2 嫌疑 = ①IMU 零偏温漂/校准时机
    (boot 唯一校准+0.3°/s 死区遮蔽自检, 温漂 40s 圈可漂 12~40°)
    ②充电宝供电波动 × 灰度陈旧字节缺陷(gray.c:93 失败冻结 s_last_byte,
    app.c:485 无条件消费 → 段状态机冻结/误推进)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
2026-07-07 tools: parse_justfloat 适配 r32 VOFA 降频(20→50ms) —— 时长/抖动统计不再假设 20ms 帧周期
    r32 把 task_vofa 降到 50ms 后, 解析器"名义 20ms/帧"的时长估算会虚短 2.5 倍;
    改为: 有 tick_ms 通道时用真实时间轴, 无则同时报 20/50ms 两种口径;
    帧间隔迟到判据从写死 >25ms 改为 >1.25×中位数(20/50ms 自适应)。
2026-07-07 feat r33: 瞄准场地常量回填(全实测): AB=1000/靶投影x=530/靶心高=500/舵机轴高=161.5mm; 零点按'中位指左'装法首猜 ZERO=0 SIGN=+1(解算角+133°落量程内, 两种符号都不越界); TILT机械固定不参与
2026-07-07 feat r34: AIM 定点打靶物理简化方案(用户拍板) —— 实装为水平360连续+垂直180位置, 题目说明4禁视觉主导作业, 360做主瞄轴不可行; 改固定指向: PAN恒发停转脉冲(建议物理锁死), TILT斜坡抬到定角(可见的调姿+指向动作, 满5s展示), 靶按光点落点摆放(规则允许: 仅约束AB外侧50cm平行线); AIM_FIXED_MODE=0 可回几何方案
2026-07-07 docs: 设计报告草稿(方案/硬件/软件/调试与测试/工程完善度 + 附录A AI使用说明含局限性实录) —— 待填: F2环数/四圈结果/照片
2026-07-07 docs: 设计报告 PDF 版(pandoc+Edge 渲染, A4 中文排版; 与 md 同源, 改 md 后可重新生成)
2026-07-07 docs: 报告删除四圈相关内容(任务概述/算法/测试表/视频清单; §6保留'主动放弃'声明) + 重新生成 PDF
2026-07-07 docs: 报告三处修订 —— 附录A收录自研电赛技能包 diansai-skill; F3 如实降级(联动运动完成/对靶命中未稳定, 视频不含瞄准); 修 PDF 标题重复(pagetitle 替代 title 元数据)
2026-07-07 docs: 重新生成 PDF(含 skill 收录/F3 降级/标题去重)
2026-07-07 docs: F2 如实标记未实现(根因=水平轴连续舵机无位置反馈, 替代方案未在截止前调通); 结论/测试表/视频清单同步
2026-07-07 docs: 附录C插入6张实车照片(压缩至~100KB/张)+图注; 重新生成带图PDF(8页)
2026-07-07 docs: 附录D精简为两条视频(F1循迹 / F3功能·无瞄准), 去掉时长列; 重出PDF并同步桌面提交包
2026-07-08 tune: AIM_TILT_FIX_DEG 116->150 (F2 现场试标值; 该方案受硬件限制未调通, 仅保留现场进度)
2026-07-08 fix r35: 微分项瞬变卫生(issue#2) + IMU静置重校/起跑门控(issue#3)
    两处 GitHub issue 的修复, 均在 20ms/10ms 控制环上, 已过对抗式 code-review。
    仅静态审查, 未真机 verify。
    ## issue #2 — 微分项瞬变(app.c track_loop_step / app_fsm_step)
    (a) 现象: 弧上偶发单拍甩头; 机理: I2C 失败帧(stale)走 dy=0 分支, 下一拍
    fresh 恢复又跳回查表值, KD=2.0 下打出 stale→0→恢复 的 ±50 单拍假 D 踢;
    修复: stale 帧维持上一拍 dy(D=0), 且 on_ladder=1 沿用弧线 KP。
    (b) 现象: F3 对靶停车 5s 续跑后第一拍甩头; 机理: g_dyaw_prev 还是停车前旧值,
    且 s_seg_prev 在 AIM 期冻结、返回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
    [app.c, app.h, empty.c]
2026-07-08 修改了舵机
2026-07-08 feat r37: 云台 bring-up + 360°连续舵机定点打靶(F2 真机调通) + 修任务表
    保存 gimbal 线在制品(r36) + r37 手势方案 + F2 现场定版。gmake 全量编译链接零错误; F2 已真机调通(激光落靶心 + 水平"转向靶"手势幅度正好)。均未做 F1 循迹 /verify; F3 待续。
    ## r36 云台 bring-up(承接队友, 之前未提交)
    - servo 驱动重构: 每通道标定表(deg 限位/脉宽/reverse) + 角度/脉宽/轨状态 getter
    - 串口 bring-up 命令 O/o/C/J/j/K/k + '?' 显示舵机状态; servo_gimbal_bringup.md 现场记录
    ## r37 定点打靶(适配 360°连续舵机)
    - 现象/机理: 水平轴实为 360°连续舵机(接 SERVO_TILT/PA16), 无位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
    [app.c, app.h, empty.c, servo.c, servo.h]
2026-07-08 fix: restore r37 aim and add gray CSV tuning
    [analyze_run_csv.py, app.c, app.h, empty.c, serial_pid_console.py]
2026-07-09 feat r38: K230 视觉闭环打靶(水平连续舵机速度环 + 垂直位置舵机 dy 比例环)
    现象: r37 定点打靶靠开环固定手势(转305ms再停), 连续舵机无位置反馈, 每趟停点
    累积漂移, 靶心全凭手调停转脉宽碰运气, 换距离/换场地就得重调。
    机理: 水平轴是360°连续舵机=速度执行器, 垂直轴是180°位置舵机; 两轴解耦后各配
    一种自然闭环——像素误差→角速度(水平)、像素误差→角度(垂直)。连续舵机转速用
    实测"从静止两次k≈1圈/4s=90°/s"标成 ω↔脉宽 分段线性模型(cont_omega_to_pulse),
    闭环对该模型不敏感, 只定增益量级。视差(激光//摄像头基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
2026-07-09 tune: 巡航基速 150→170, 右轮配平 2→5(现场整定回填)
    现场调参后回填的两个 drive 默认值(串口在线调, 断电即失, 须写回常量再烧),
    与本轮 r38 视觉瞄准无关, 单独成 commit:
    - BASE_SPEED 150→170: 巡航占空当量, 约提速 13%。
    - DRIVE_TRIM_DUTY_R 2→5: 右轮占空偏置。
    ⚠ README §3 定版表仍记 BASE_SPEED=150; 若确认上车请同步更新, 否则日后回退定版
    会静默改回巡航速度。
2026-07-09 fix r39: 移除 IMU 里的编码器互补滤波(恢复 r37 验收态的纯陀螺积分)
    - 现象: 直线段(seg0/seg2)缓慢画弧; 100cm 直线横向偏约 4cm。开机 2s 静止漂移自检却报
    合格数字。此前"烧录后第一次运行顺畅、之后走不直"的怪相亦与之相符。
    - 机理: imu_update() 里跑着 fused = 0.98*gyro + 0.02*enc_yaw_rate 的互补滤波, 喂它的是
    本车自己判过死刑的两个编码器(app.c:141-147 台架实锤: 左间歇无信号 / 右 ±20% 电气毛刺;
    DRIVE_OPEN_LOOP=1 正是为把它们踢出控制路径)。三处致命:
    1) "只占 2%" 是量纲错觉。enc_yaw_rate = 每拍距离差 / dt(10ms), 那个除法放大了 100 倍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
    [mpu6050.c]
2026-07-09 fix r39: 弧上"太肉/出弯" = 纯 P 的稳态偏差; 用场地几何做曲率前馈
    - 现象: 弧线巡线响应"太肉", 车骑在弯道外侧, 最后出弯; 严重时线彻底离开灰度阵列。
    - 机理: 弧段是纯 PD 打在灰度质心上, 没有前馈也没有积分。可 R=400mm 的弧要求一个恒定的
    转向量, 纯 P 只能靠"一直保持一个偏差"把它顶出来 —— 稳态偏差不可能为零, 且正比于车速:
    diff_ss = base·track/(2R) = 29.75 @base=170 (左右电机增益 G 在推导中约掉)
    稳态质心 = diff_ss/(kp_arc·arc_err_to_deg) = 29.75/0.42 ≈ 71 ≈ 0.7 个探头间距
    线常驻阵列外缘 -> gray_hits 掉到 1 -> line_ok=0(min_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
    [app.c, empty.c]
2026-07-09 fix r40: 出弧欠转右甩 = 前馈保持窗漏算了灰度阵列的前置量
    - 现象: r39 上车后弧线巡线已很稳(gray_err 回到 0 附近), 但出第一个弯时车"先直冲出去、
    然后猛地向右一甩"。真机确认: 甩完航向是对的, 车身位置落在 C→D 线左侧。
    - 机理: 我在 r39 写 ARC_FF_HOLD_FRAMES=3 的依据是"C 处切线即 C→D 方向, 所以线一没就该
    直走"。这句话对【传感器】成立, 对【车体】不成立 —— 线是灰度阵列丢的, 而阵列装在驱动
    轮轴前方 L 处; 那一刻车体还在 C 点后方 L 毫米、仍骑在弧上, 必须再画 L/R 弧度才走到 C。
    L=110/R=400 => 15.8°。只托 3 帧 =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
    [app.c, empty.c]
2026-07-09 修改了 cm
